rien-et-la-reine/tome/README.md

# tome

seeing if i can make a clamshell ereader + music player from scratch(-ish)

inspired in part by The Open Book (https://github.com/joeycastillo/The-Open-Book)

Firmware: [tavernkeep](https://github.com/rien-et-la-reine/tavernkeep)

## License

Copyright Harsh Patel 2026.

The following notice applies to all hardware design files in this repository.

This source describes Open Hardware and is licensed under the CERN-OHL-S v2.
You may redistribute and modify this source and make products using it under the terms of the CERN-OHL-S v2 (https://ohwr.org/cern_ohl_s_v2.txt).

This source is distributed WITHOUT ANY EXPRESS OR IMPLIED WARRANTY, INCLUDING OF MERCHANTABILITY, SATISFACTORY QUALITY AND FITNESS FOR A PARTICULAR PURPOSE.
Please see the CERN-OHL-S v2 for applicable conditions.

Source location: https://github.com/rien-et-la-reine/tome

As per CERN-OHL-S v2 section 4, should you produce hardware based on this source, you must where practicable maintain the Source Location visible on the external case or other products you make using this source.

Commits up to and including `8ce5c31` were published under CC BY-SA 4.0 and remain available under that licence.
