rien-et-la-reine/tome/Tome.kicad_pcb

## KiCad design Tome.kicad_pcb (2026-08-22)

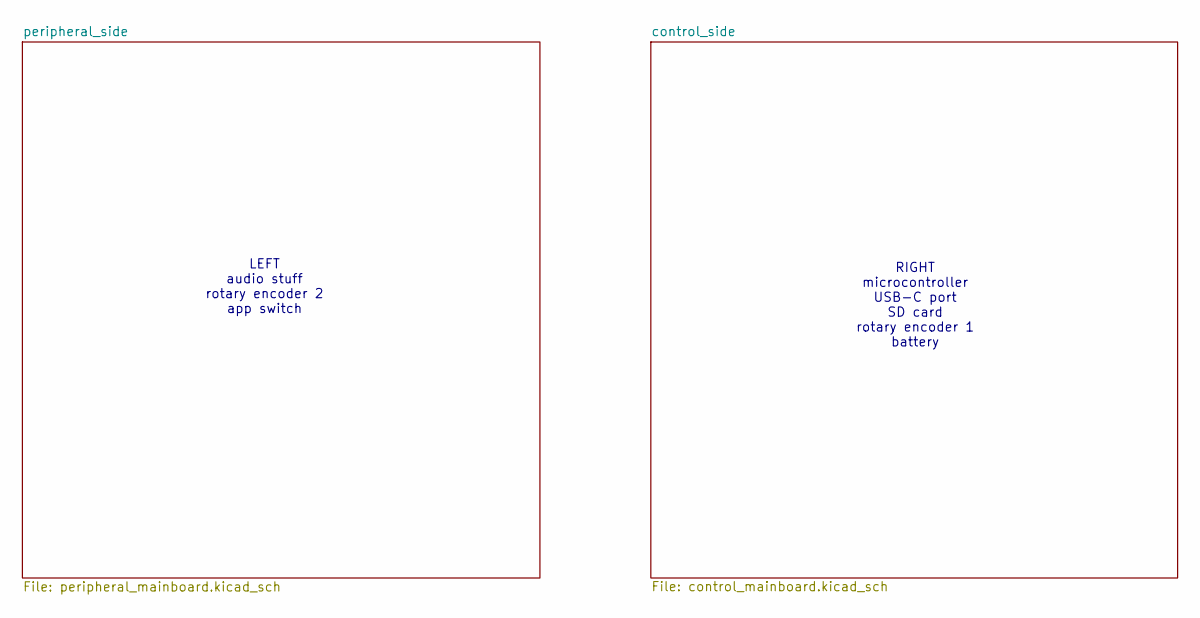
[picture p1: schematic Tome.kicad_sch]

Notes on the sheet:
RIGHT microcontroller USB-C port SD card rotary encoder 1 battery
LEFT audio stuff rotary encoder 2 app switch

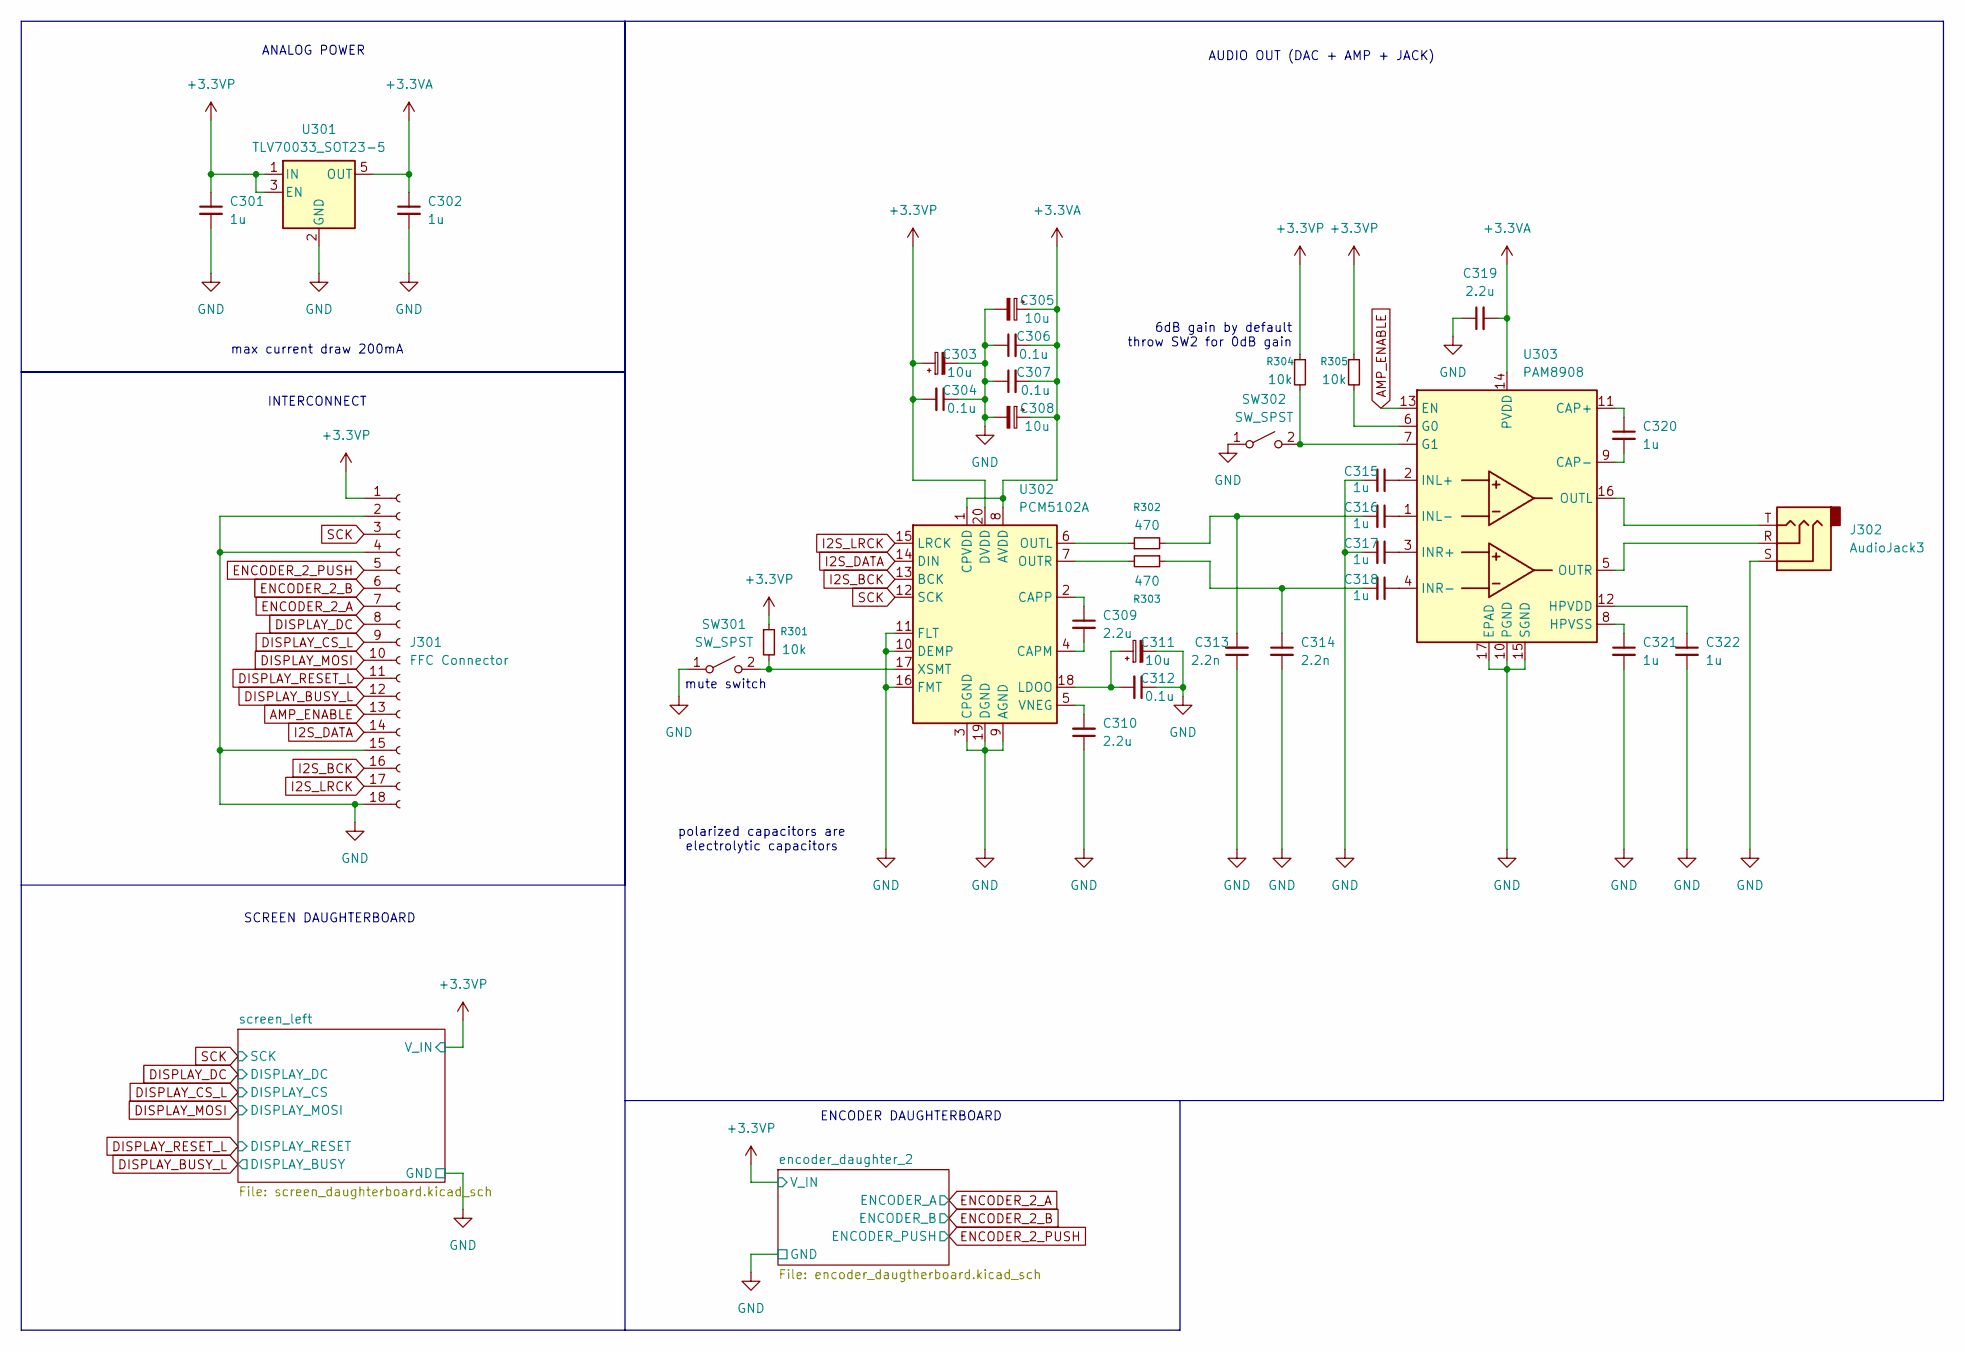
[picture p2: schematic peripheral_mainboard.kicad_sch, Tome: Peripheral-Side Board]

Parts:
C301, C302, C315, C316, C317, C318, C320, C321, C322: 1u; C_0805_2012Metric
C303, C305, C308, C311: 10u; CP_Elec_4x4.5
C304, C306, C307, C312: 0.1u; C_1206_3216Metric
C309, C310, C319: 2.2u; C_0402_1005Metric
C313, C314: 2.2n; C_0805_2012Metric
J301: FFC Connector; JUSHUO_AFA07-S18FCA-00_1x18-1MP_P1.0mm_Horizontal
J302: AudioJack3; Jack_3.5mm_CUI_SJ1-3523N_Horizontal
R301, R304, R305: 10k; R_1206_3216Metric
R302, R303: 470; R_0603_1608Metric
SW301, SW302: SW_SPST; SW_SPDT_CK_JS102011SAQN
U301: TLV70033_SOT23-5; SOT-23-5
U302: PCM5102A; TSSOP-20_4.4x6.5mm_P0.65mm
U303: PAM8908; QFN-16-1EP_3x3mm_P0.5mm_EP1.7x1.7mm

Connections:
+3.3VA: C302.1, C305.1, C306.2, C307.2, C308.1, C319.2, U301.5 (OUT), U302.1 (CPVDD), U302.8 (AVDD), U303.14 (PVDD)
+3.3VP: C301.1, C303.1, C304.2, J301.1, R301.1, R304.1, R305.1, U301.1 (IN), U301.3 (EN), U302.20 (DVDD); also elsewhere on the board
AMP_ENABLE: J301.13, U303.13 (EN); also elsewhere on the board
DISPLAY_BUSY_L: J301.12; also elsewhere on the board
DISPLAY_CS_L: J301.9; also elsewhere on the board
DISPLAY_DC: J301.8; also elsewhere on the board
DISPLAY_MOSI: J301.10; also elsewhere on the board
DISPLAY_RESET_L: J301.11; also elsewhere on the board
ENCODER_2_A: J301.7; also elsewhere on the board
ENCODER_2_B: J301.6; also elsewhere on the board
ENCODER_2_PUSH: J301.5; also elsewhere on the board
GND: C301.2, C302.2, C303.2, C304.1, C305.2, C306.1, C307.1, C308.2, C310.1, C311.2, C312.1, C313.1, C314.2, C315.2, C317.2, C319.1, C321.2, C322.2, J301.2, J301.4, J301.15, J301.18, J302.S, SW301.1 (A), SW302.1 (A), U301.2 (GND), U302.3 (CPGND), U302.9 (AGND), U302.10 (DEMP), U302.11 (FLT), U302.16 (FMT), U302.19 (DGND), U303.10 (PGND), U303.15 (SGND), U303.17 (EPAD); also elsewhere on the board
I2S_BCK: J301.16, U302.13 (BCK); also elsewhere on the board
I2S_DATA: J301.14, U302.14 (DIN); also elsewhere on the board
I2S_LRCK: J301.17, U302.15 (LRCK); also elsewhere on the board
unnamed: C313.2, C316.2, R302.2
unnamed: C314.1, C318.2, R303.1
unnamed: R301.2, SW301.2 (B), U302.17 (XSMT)
unnamed: R304.2, SW302.2 (B), U303.7 (G1)
unnamed: C309.2, U302.4 (CAPM)
unnamed: C309.1, U302.2 (CAPP)
unnamed: C311.1, C312.2, U302.18 (LDOO)
unnamed: R302.1, U302.6 (OUTL)
unnamed: R303.2, U302.7 (OUTR)
unnamed: C310.2, U302.5 (VNEG)
unnamed: C320.1, U303.11 (CAP+)
unnamed: C320.2, U303.9 (CAP-)
unnamed: R305.2, U303.6 (G0)
unnamed: C322.1, U303.12 (HPVDD)
unnamed: C321.1, U303.8 (HPVSS)
unnamed: C315.1, U303.2 (INL+)
unnamed: C316.1, U303.1 (INL-)
unnamed: C317.1, U303.3 (INR+)
unnamed: C318.1, U303.4 (INR-)
unnamed: J302.T, U303.16 (OUTL)
unnamed: J302.R, U303.5 (OUTR)
SCK: J301.3, U302.12 (SCK); also elsewhere on the board

Notes on the sheet:
6dB gain by default throw SW2 for 0dB gain
SCREEN DAUGHTERBOARD
polarized capacitors are electrolytic capacitors
max current draw 200mA
ANALOG POWER
AUDIO OUT (DAC + AMP + JACK)
INTERCONNECT
ENCODER DAUGHTERBOARD
mute switch

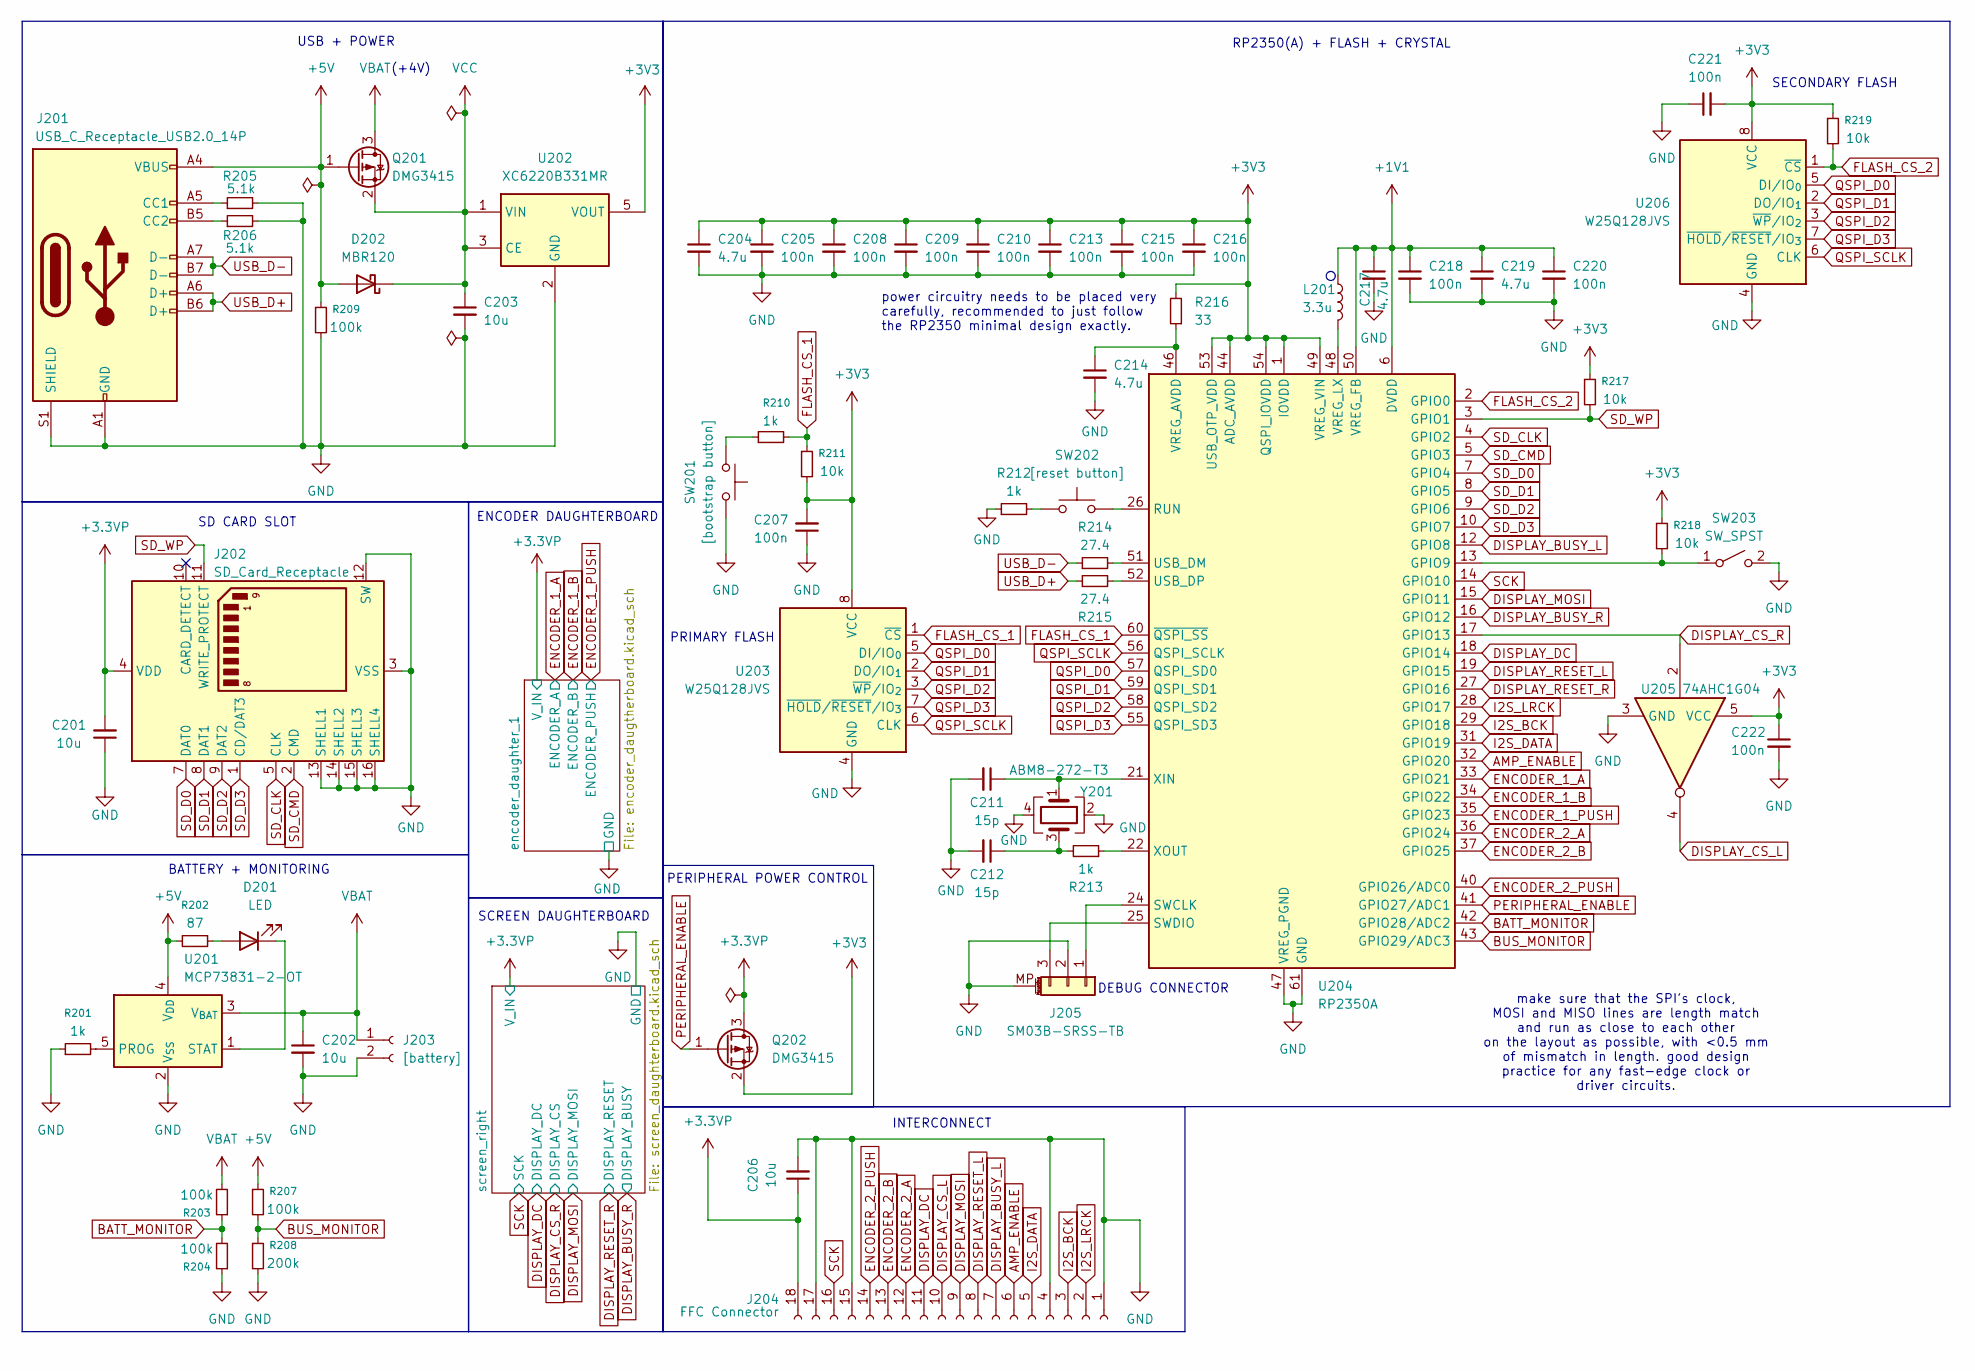
[picture p3: schematic control_mainboard.kicad_sch, Tome: Control-Side Board]

Parts:
C201, C202, C206: 10u; C_0805_2012Metric
C203: 10u; C_0402_1005Metric
C204, C214, C217, C219: 4.7u; C_0402_1005Metric
C205, C207, C208, C209, C210, C213, C215, C216, C218, C220, C221, C222: 100n; C_0402_1005Metric
C211, C212: 15p; C_0402_1005Metric
D201: LED; LED_0603_1608Metric
D202: MBR120; D_SOD-123
J201: USB_C_Receptacle_USB2.0_14P; USB_C_Receptacle_GCT_USB4105-xx-A_16P_TopMnt_Horizontal
J202: SD_Card_Receptacle; SD_Hirose_DM1AA_SF_PEJ82
J203: [battery]; JST_PH_S2B-PH-K_1x02_P2.00mm_Horizontal
J204: FFC Connector; JUSHUO_AFA07-S18FCA-00_1x18-1MP_P1.0mm_Horizontal
J205: SM03B-SRSS-TB; JST_SH_SM03B-SRSS-TB_1x03-1MP_P1.00mm_Horizontal
L201: 3.3u; L_pol_2016
Q201, Q202: DMG3415; SOT-23
R201: 1k; R_1206_3216Metric
R202: 87; R_1206_3216Metric
R203, R204, R207: 100k; R_1206_3216Metric
R205, R206: 5.1k; R_0402_1005Metric
R208: 200k; R_0805_2012Metric
R209: 100k; R_0402_1005Metric
R210, R213: 1k; R_0402_1005Metric
R211, R219: 10k; R_0402_1005Metric
R212: 1k; R_0603_1608Metric
R214, R215: 27.4; R_0402_1005Metric
R216: 33; R_0402_1005Metric
R217, R218: 10k; R_1206_3216Metric
SW201: [bootstrap button]; Panasonic_EVQPUK_EVQPUB
SW202: [reset button]; Panasonic_EVQPUK_EVQPUB
SW203: SW_SPST; SW_SPDT_CK_JS102011SAQN
U201: MCP73831-2-OT; SOT-23-5
U202: XC6220B331MR; SOT-23-5
U203, U206: W25Q128JVS; SOIC-8_5.3x5.3mm_P1.27mm
U204: RP2350A; QFN-60-1EP_7x7mm_P0.4mm_EP3.4x3.4mm
U205: 74AHC1G04; SOT-23-5_HandSoldering
Y201: ABM8-272-T3; Crystal_SMD_3225-4Pin_3.2x2.5mm

Connections:
+1V1: C217.1, C218.1, C219.1, C220.1, L201.1, U204.6 (DVDD), U204.23 (DVDD), U204.39 (DVDD), U204.50 (VREG_FB)
+3.3VP: C201.2, C206.1, J202.4 (VDD), J204.18, Q202.3 (D); also elsewhere on the board
+3V3: C204.1, C205.1, C207.2, C208.1, C209.1, C210.1, C213.1, C215.1, C216.1, C221.2, C222.1, Q202.2 (S), R211.2, R216.2, R217.1, R218.1, R219.1, U202.5 (VOUT), U203.8 (VCC), U204.1 (IOVDD), U204.11 (IOVDD), U204.20 (IOVDD), U204.30 (IOVDD), U204.38 (IOVDD), U204.44 (ADC_AVDD), U204.45 (IOVDD), U204.49 (VREG_VIN), U204.53 (USB_OTP_VDD), U204.54 (QSPI_IOVDD), U205.5 (VCC), U206.8 (VCC)
+5V: D202.2 (A), J201.A4 (VBUS), J201.A9 (VBUS), J201.B4 (VBUS), J201.B9 (VBUS), Q201.1 (G), R202.2, R207.1, R209.1, U201.4 (V_{DD})
AMP_ENABLE: J204.6, U204.32 (GPIO20); also elsewhere on the board
BATT_MONITOR: R203.1, R204.2, U204.42 (GPIO28/ADC2)
BUS_MONITOR: R207.2, R208.1, U204.43 (GPIO29/ADC3)
DISPLAY_BUSY_L: J204.7, U204.12 (GPIO8); also elsewhere on the board
DISPLAY_BUSY_R: U204.16 (GPIO12); also elsewhere on the board
DISPLAY_CS_L: J204.10, U205.4; also elsewhere on the board
DISPLAY_CS_R: U204.17 (GPIO13), U205.2; also elsewhere on the board
DISPLAY_DC: J204.11, U204.18 (GPIO14); also elsewhere on the board
DISPLAY_MOSI: J204.9, U204.15 (GPIO11); also elsewhere on the board
DISPLAY_RESET_L: J204.8, U204.19 (GPIO15); also elsewhere on the board
DISPLAY_RESET_R: U204.27 (GPIO16); also elsewhere on the board
ENCODER_1_A: U204.33 (GPIO21); also elsewhere on the board
ENCODER_1_B: U204.34 (GPIO22); also elsewhere on the board
ENCODER_1_PUSH: U204.35 (GPIO23); also elsewhere on the board
ENCODER_2_A: J204.12, U204.36 (GPIO24); also elsewhere on the board
ENCODER_2_B: J204.13, U204.37 (GPIO25); also elsewhere on the board
ENCODER_2_PUSH: J204.14, U204.40 (GPIO26/ADC0); also elsewhere on the board
FLASH_CS_1: R210.2, R211.1, U203.1 (~CS), U204.60 (~QSPI_SS)
FLASH_CS_2: R219.2, U204.2 (GPIO0), U206.1 (~CS)
GND: C201.1, C202.2, C203.2, C204.2, C205.2, C206.2, C207.1, C208.2, C209.2, C210.2, C211.2, C212.2, C213.2, C214.2, C215.2, C216.2, C217.2, C218.2, C219.2, C220.2, C221.1, C222.2, J201.A1 (GND), J201.A12 (GND), J201.B1 (GND), J201.B12 (GND), J201.S1 (SHIELD), J202.3 (VSS), J202.6 (VSS), J202.12 (SW), J202.13 (SHELL1), J202.14 (SHELL2), J202.15 (SHELL3), J202.16 (SHELL4), J203.2, J204.1, J204.4, J204.15, J204.17, J205.2, J205.MP (MountPin), R201.1, R204.1, R205.2, R206.2, R208.2, R209.2, R212.1, SW201.2, SW203.2 (B), U201.2 (V_{SS}), U202.2 (GND), U203.4 (GND), U204.47 (VREG_PGND), U204.61 (GND), U205.3 (GND), U206.4 (GND), Y201.2, Y201.4; also elsewhere on the board
I2S_BCK: J204.3, U204.29 (GPIO18); also elsewhere on the board
I2S_DATA: J204.5, U204.31 (GPIO19); also elsewhere on the board
I2S_LRCK: J204.2, U204.28 (GPIO17); also elsewhere on the board
unnamed: C212.1, R213.2, Y201.3
unnamed: D201.2 (A), R202.1
unnamed: D201.1 (K), U201.1 (STAT)
unnamed: J201.A5 (CC1), R205.1
unnamed: J201.B5 (CC2), R206.1
unnamed: J205.1, U204.24 (SWCLK)
unnamed: J205.3, U204.25 (SWDIO)
unnamed: R210.1, SW201.1
unnamed: R212.2, SW202.1
unnamed: R218.2, SW203.1 (A), U204.13 (GPIO9)
unnamed: R201.2, U201.5 (PROG)
unnamed: SW202.2, U204.26 (RUN)
unnamed: R214.2, U204.51 (USB_DM)
unnamed: R215.2, U204.52 (USB_DP)
unnamed: C214.1, R216.1, U204.46 (VREG_AVDD)
unnamed: L201.2, U204.48 (VREG_LX)
unnamed: C211.1, U204.21 (XIN), Y201.1
unnamed: R213.1, U204.22 (XOUT)
PERIPHERAL_ENABLE: Q202.1 (G), U204.41 (GPIO27/ADC1)
QSPI_D0: U203.5 (DI/IO_{0}), U204.57 (QSPI_SD0), U206.5 (DI/IO_{0})
QSPI_D1: U203.2 (DO/IO_{1}), U204.59 (QSPI_SD1), U206.2 (DO/IO_{1})
QSPI_D2: U203.3 (~WP/IO_{2}), U204.58 (QSPI_SD2), U206.3 (~WP/IO_{2})
QSPI_D3: U203.7 (~HOLD/~RESET/IO_{3}), U204.55 (QSPI_SD3), U206.7 (~HOLD/~RESET/IO_{3})
QSPI_SCLK: U203.6 (CLK), U204.56 (QSPI_SCLK), U206.6 (CLK)
SCK: J204.16, U204.14 (GPIO10); also elsewhere on the board
SD_CLK: J202.5 (CLK), U204.4 (GPIO2)
SD_CMD: J202.2 (CMD), U204.5 (GPIO3)
SD_D0: J202.7 (DAT0), U204.7 (GPIO4)
SD_D1: J202.8 (DAT1), U204.8 (GPIO5)
SD_D2: J202.9 (DAT2), U204.9 (GPIO6)
SD_D3: J202.1 (CD/DAT3), U204.10 (GPIO7)
SD_WP: J202.11 (WRITE_PROTECT), R217.2, U204.3 (GPIO1)
USB_D+: J201.A6 (D+), J201.B6 (D+), R215.1
USB_D-: J201.A7 (D-), J201.B7 (D-), R214.1
VBAT: C202.1, J203.1, Q201.3 (D), R203.2, U201.3 (V_{BAT})
VCC: C203.1, D202.1 (K), Q201.2 (S), U202.1 (VIN), U202.3 (CE)

Notes on the sheet:
SCREEN DAUGHTERBOARD
SECONDARY FLASH
DEBUG CONNECTOR
SD CARD SLOT
make sure that the SPI's clock, MOSI and MISO lines are length match and run as close to each other on the layout as possible, with <0.5 mm of mismatch in length. good design practice for any fast-edge clock or driver circuits.
INTERCONNECT
power circuitry needs to be placed very carefully, recommended to just follow the RP2350 minimal design exactly.
BATTERY + MONITORING
PRIMARY FLASH
ENCODER DAUGHTERBOARD
(+4V)
PERIPHERAL POWER CONTROL
USB + POWER
RP2350(A) + FLASH + CRYSTAL

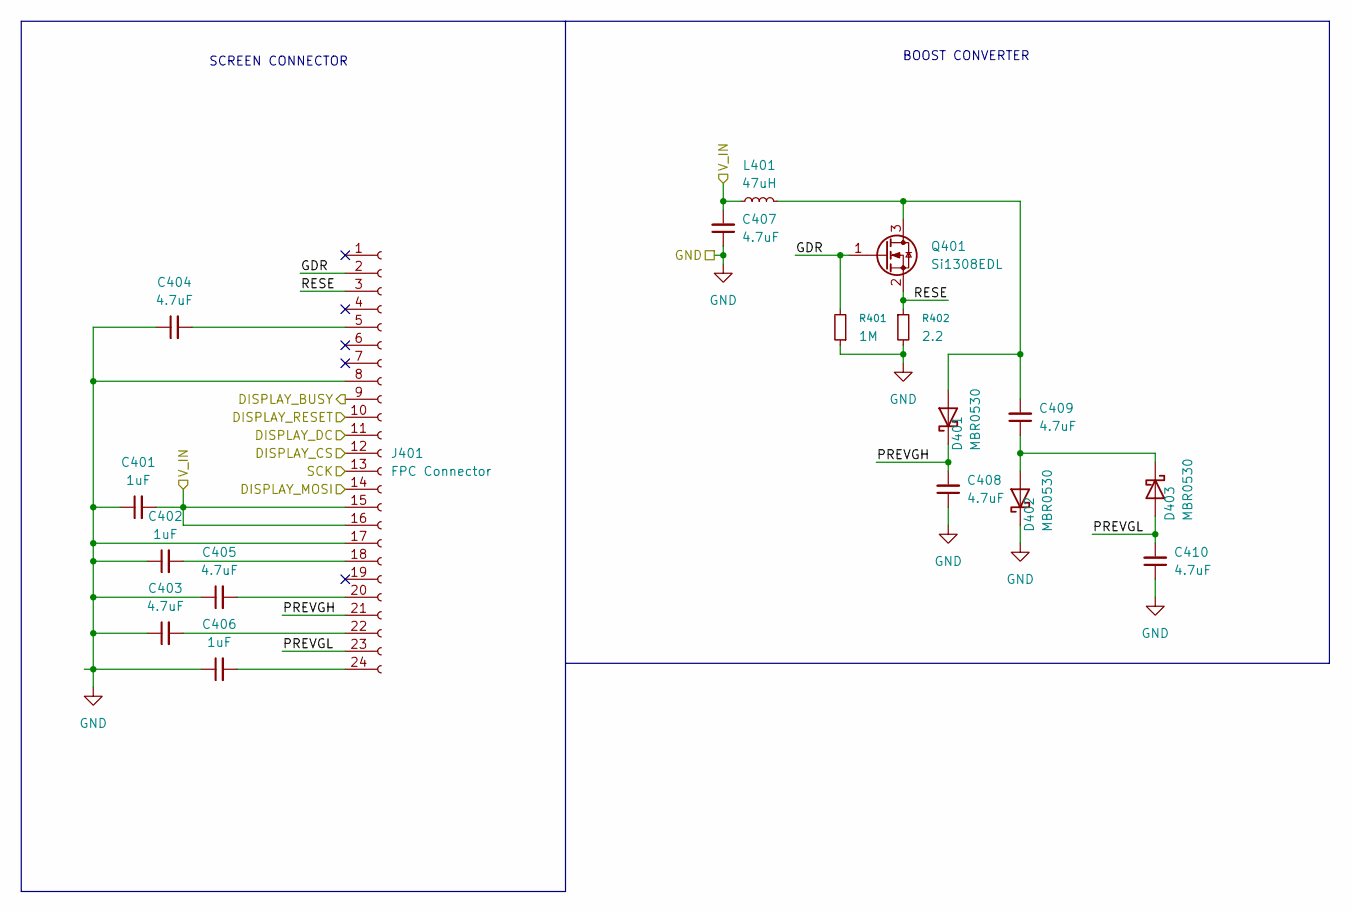
[picture p4: schematic screen_daughterboard.kicad_sch, Tome: Display Daughterboard]

Parts:
C401, C402, C406: 1uF; C_0805_2012Metric
C403, C404, C405, C407, C408, C409, C410: 4.7uF; C_0402_1005Metric
D401, D402, D403: MBR0530; D_SOD-123
J401: FPC Connector; Hirose_FH12-24S-0.5SH_1x24-1MP_P0.50mm_Horizontal
L401: 47uH; L_APV_ANR3015
Q401: Si1308EDL; SOT-323_SC-70
R401: 1M; R_0805_2012Metric
R402: 2.2; R_0603_1608Metric

Connections:
+3.3VP: C401.2, C407.2, J401.15, J401.16, L401.1; also elsewhere on the board
/control_side/screen_right/GDR: J401.2, Q401.1 (G), R401.2
/control_side/screen_right/PREVGH: C408.2, D401.1 (K), J401.21
/control_side/screen_right/PREVGL: C410.2, D403.2 (A), J401.23
/control_side/screen_right/RESE: J401.3, Q401.2 (S), R402.1
DISPLAY_BUSY_R: J401.9; also elsewhere on the board
DISPLAY_CS_R: J401.12; also elsewhere on the board
DISPLAY_DC: J401.11; also elsewhere on the board
DISPLAY_MOSI: J401.14; also elsewhere on the board
DISPLAY_RESET_R: J401.10; also elsewhere on the board
GND: C401.1, C402.1, C403.1, C404.1, C405.1, C406.1, C407.1, C408.1, C410.1, D402.1 (K), J401.8, J401.17, R401.1, R402.2; also elsewhere on the board
unnamed: C409.2, D401.2 (A), L401.2, Q401.3 (D)
unnamed: C409.1, D402.2 (A), D403.1 (K)
unnamed: C404.2, J401.5
unnamed: C402.2, J401.18
unnamed: C405.2, J401.20
unnamed: C403.2, J401.22
unnamed: C406.2, J401.24
SCK: J401.13; also elsewhere on the board

Parts of its further copies:
C501, C502, C506: 1uF; C_0805_2012Metric
C503, C504, C505, C507, C508, C509, C510: 4.7uF; C_0402_1005Metric
D501, D502, D503: MBR0530; D_SOD-123
J501: FPC Connector; Hirose_FH12-24S-0.5SH_1x24-1MP_P0.50mm_Horizontal
L501: 47uH; L_APV_ANR3015
Q501: Si1308EDL; SOT-323_SC-70
R501: 1M; R_0805_2012Metric
R502: 2.2; R_0603_1608Metric

Connections of its further copies:
+3.3VP: C501.2, C507.2, J501.15, J501.16, L501.1; also elsewhere on the board
/peripheral_side/screen_left/GDR: J501.2, Q501.1 (G), R501.2
/peripheral_side/screen_left/PREVGH: C508.2, D501.1 (K), J501.21
/peripheral_side/screen_left/PREVGL: C510.2, D503.2 (A), J501.23
/peripheral_side/screen_left/RESE: J501.3, Q501.2 (S), R502.1
DISPLAY_BUSY_L: J501.9; also elsewhere on the board
DISPLAY_CS_L: J501.12; also elsewhere on the board
DISPLAY_DC: J501.11; also elsewhere on the board
DISPLAY_MOSI: J501.14; also elsewhere on the board
DISPLAY_RESET_L: J501.10; also elsewhere on the board
GND: C501.1, C502.1, C503.1, C504.1, C505.1, C506.1, C507.1, C508.1, C510.1, D502.1 (K), J501.8, J501.17, R501.1, R502.2; also elsewhere on the board
unnamed: C509.2, D501.2 (A), L501.2, Q501.3 (D)
unnamed: C509.1, D502.2 (A), D503.1 (K)
unnamed: C504.2, J501.5
unnamed: C502.2, J501.18
unnamed: C505.2, J501.20
unnamed: C503.2, J501.22
unnamed: C506.2, J501.24
SCK: J501.13; also elsewhere on the board

Notes on the sheet:
BOOST CONVERTER
SCREEN CONNECTOR

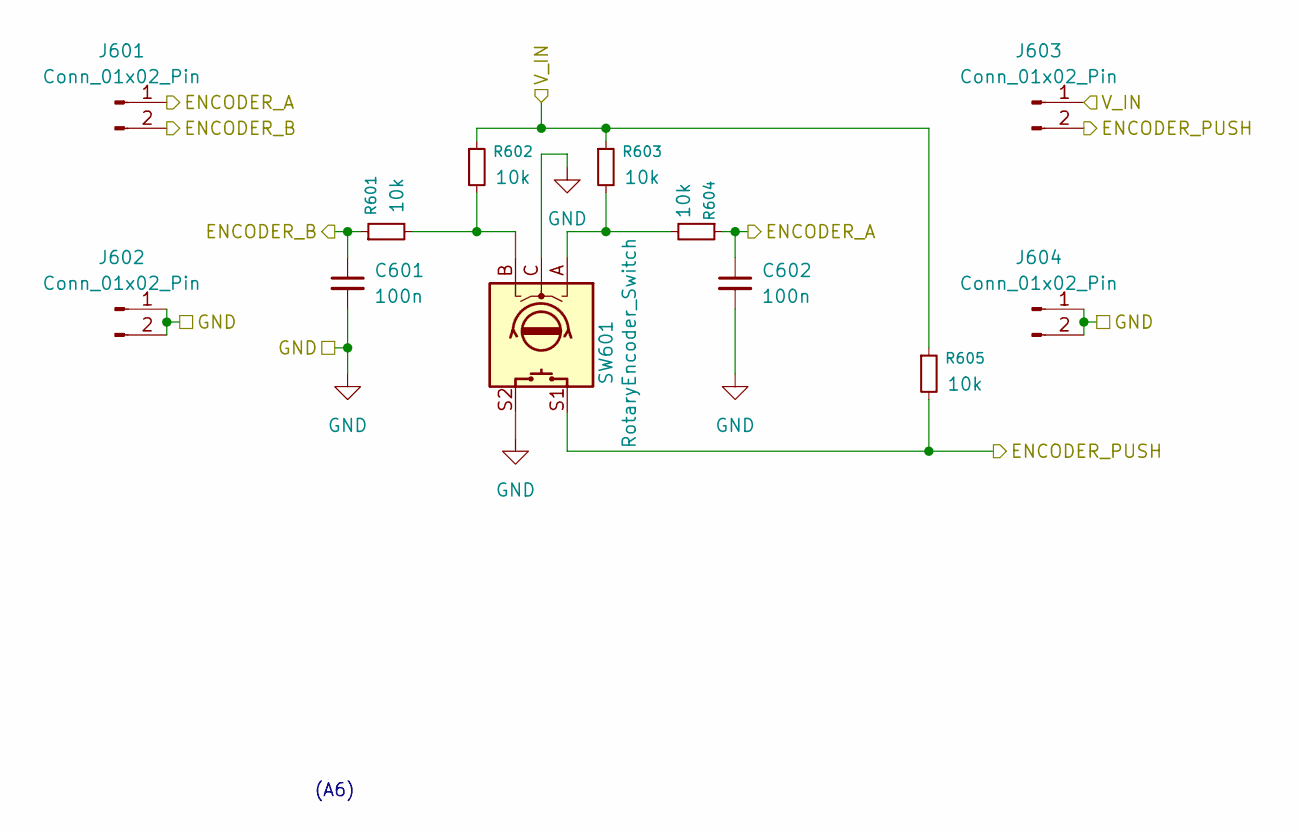
[picture p5: schematic encoder_daugtherboard.kicad_sch, Tome: Encoder Daughterboard]

Parts:
C601, C602: 100n; C_0402_1005Metric
J601, J602, J603, J604: Conn_01x02_Pin; PinHeader_1x02_P2.00mm_Vertical
R601, R602, R603, R604, R605: 10k; R_1206_3216Metric
SW601: RotaryEncoder_Switch; RotaryEncoder_Alps_EC11E-Switch_Vertical_H20mm

Connections:
+3.3VP: J603.1, R602.1, R603.1, R605.1; also elsewhere on the board
ENCODER_1_A: C602.1, J601.1, R604.1; also elsewhere on the board
ENCODER_1_B: C601.1, J601.2, R601.1; also elsewhere on the board
ENCODER_1_PUSH: J603.2, R605.2, SW601.S1; also elsewhere on the board
GND: C601.2, C602.2, J602.1, J602.2, J604.1, J604.2, SW601.C, SW601.S2; also elsewhere on the board
unnamed: R601.2, R602.2, SW601.B
unnamed: R603.2, R604.2, SW601.A

Parts of its further copies:
C701, C702: 100n; C_0402_1005Metric
J701, J702, J703, J704: Conn_01x02_Pin; PinHeader_1x02_P2.00mm_Vertical
R701, R702, R703, R704, R705: 10k; R_1206_3216Metric
SW701: RotaryEncoder_Switch; RotaryEncoder_Alps_EC11E-Switch_Vertical_H20mm

Connections of its further copies:
+3.3VP: J703.1, R702.1, R703.1, R705.1; also elsewhere on the board
ENCODER_2_A: C702.1, J701.1, R704.1; also elsewhere on the board
ENCODER_2_B: C701.1, J701.2, R701.1; also elsewhere on the board
ENCODER_2_PUSH: J703.2, R705.2, SW701.S1; also elsewhere on the board
GND: C701.2, C702.2, J702.1, J702.2, J704.1, J704.2, SW701.C, SW701.S2; also elsewhere on the board
unnamed: R701.2, R702.2, SW701.B
unnamed: R703.2, R704.2, SW701.A

Notes on the sheet:
(A6)

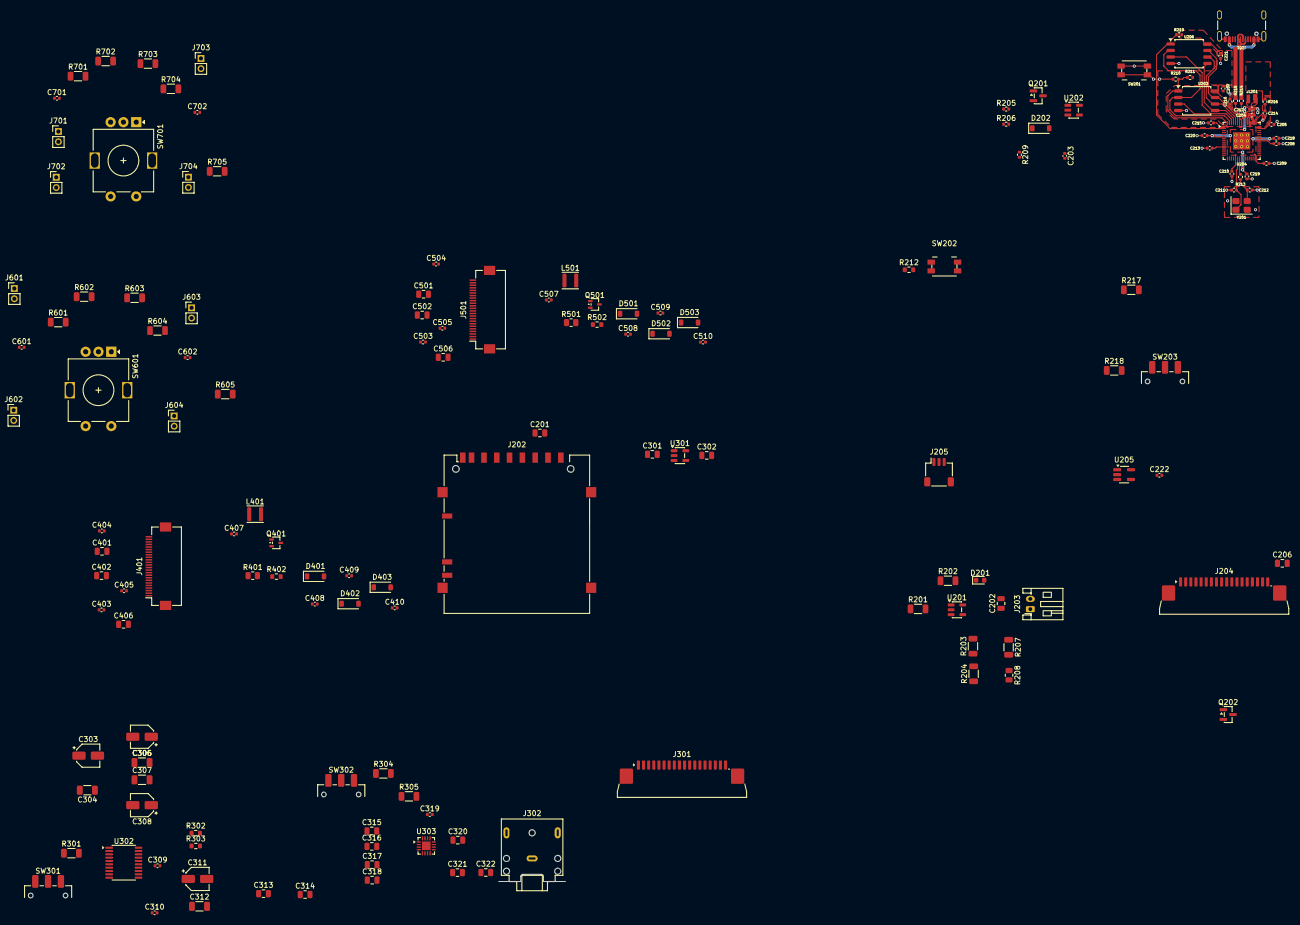
[picture p6: board Tome.kicad_pcb from above]

Board: 2 copper layers, 155 parts (0 on the bottom side), 111 nets.
