rien-et-la-reine/tome/(commit log)

2026-02-05 upload KiCad Project
    [Tome.kicad_pcb, Tome.kicad_sch, encoder_daughterboard.kicad_sch, encoder_daugtherboard.kicad_sch]
2026-02-05 update page size
    [encoder_daugtherboard.kicad_sch]
2026-02-05 unused schematic removal
    [encoder_daughterboard.kicad_sch]
2026-02-05 adjusting pin assignments
    [Tome.kicad_sch]
2026-02-05 fixing pullup resistors
    [Tome.kicad_sch]
2026-02-06 removing incorrect pullups
    [Tome.kicad_sch]
2026-02-06 split schematic based on physical PCB split
    [Tome.kicad_sch, control_mainboard.kicad_sch, encoder_daugtherboard.kicad_sch, peripheral_mainboard.kicad_sch, screen_daughterboard.kicad_sch]
2026-02-06 fixed page numbers
    and adjusted some label types
    [Tome.kicad_sch, control_mainboard.kicad_sch, encoder_daugtherboard.kicad_sch, peripheral_mainboard.kicad_sch, screen_daughterboard.kicad_sch]
2026-02-07 separating schematics based on board
    finished splitting every component up into separate sheets in the schematic based on what physical board it's going on
    [Tome.kicad_sch, control_mainboard.kicad_sch, encoder_daugtherboard.kicad_sch, peripheral_mainboard.kicad_sch, screen_daughterboard.kicad_sch]
2026-02-08 assigning pcb footprints
    assigned pcb footprints to most components:
    - rotary encoder footprint will need slight modification to fit bourns PEC11L
    - need to finalize components for reset button and the four switches before assigning those footprints
    [control_mainboard.kicad_sch, encoder_daugtherboard.kicad_sch, peripheral_mainboard.kicad_sch, screen_daughterboard.kicad_sch]
2026-02-08 removed external footprint/model
    these were from ultralibrarian and should never have been included here, my bad
    [peripheral_mainboard.kicad_sch]
2026-02-08 replaced DAC footprint
    there was literally a built-in footprint for the DAC in kicad already the whole time...
    [peripheral_mainboard.kicad_sch]
2026-02-09 finalizing schematics
    connected the new DAC footprint, filled in title blocks
    [Tome.kicad_sch, control_mainboard.kicad_sch, encoder_daugtherboard.kicad_sch, peripheral_mainboard.kicad_sch, screen_daughterboard.kicad_sch]
2026-02-11 corrected connector orientation
    [control_mainboard.kicad_sch]
2026-02-12 working on PCBs
    [Tome.kicad_pcb, encoder_daugtherboard.kicad_sch]
2026-02-12 assigned switch and reset button footprints
    all footprints now assigned*
    *will probably need something to connect the encoder daughterboard to the main boards
    [control_mainboard.kicad_sch, peripheral_mainboard.kicad_sch]
2026-02-12 different encoder board layout
    [Tome.kicad_pcb, encoder_daugtherboard.kicad_sch]
2026-02-16 workshopping encoder board
    [Tome.kicad_pcb, encoder_daugtherboard.kicad_sch]
2026-02-20 switching to RP2350
    [control_mainboard.kicad_sch, encoder_daugtherboard.kicad_sch, screen_daughterboard.kicad_sch]
2026-02-23 wiring write protect to card detect
    need to reduce GPIO pins used so wiring write protect on the SD card port to lock card detect high directly instead of connecting to the microcontroller. this should prevent the card from being detected at all if it's write protected, which is important because we cannot write bookmarks into a card that is read only (and I don't want to make a read-only mode, I don't see a reason to write protect a books/audio files card anyway)
    [control_mainboard.kicad_sch]
2026-02-23 simplified card detect/write protect
    read the datasheet wrong, can just use the write protect pin, it's open when inserted card is write protected and also when there is no card, and pulled down when a card that is write enabled is inserted, so it can also work as a card detect.
    [control_mainboard.kicad_sch]
2026-02-23 update left/right interconnect
    [control_mainboard.kicad_sch, peripheral_mainboard.kicad_sch]
2026-02-23 charge status LED
    [control_mainboard.kicad_sch]
2026-02-24 updating schematic
    [control_mainboard.kicad_sch, encoder_daugtherboard.kicad_sch, peripheral_mainboard.kicad_sch, screen_daughterboard.kicad_sch]
2026-02-24 added secondary flash to schematic
    [control_mainboard.kicad_sch]
2026-08-10 update footprints and labeling
    [Tome.kicad_pcb, Tome.kicad_sch, control_mainboard.kicad_sch, encoder_daugtherboard.kicad_sch, peripheral_mainboard.kicad_sch, screen_daughterboard.kicad_sch]
2026-08-11 grouping
    grouping components together based on schematic to organize things, in prep for arranging them for routing
    [Tome.kicad_pcb, control_mainboard.kicad_sch]
2026-08-13 voltage regulator circuit
    routed the voltage regulator circuit following strongly suggested layout from the rp2350 hardware design doc, sized decoupling capacitors down
    [Tome.kicad_pcb, control_mainboard.kicad_sch, encoder_daugtherboard.kicad_sch, screen_daughterboard.kicad_sch]
2026-08-13 started placing decoupling capacitors
    [Tome.kicad_pcb, control_mainboard.kicad_sch]
2026-08-14 crystal oscillator
    [Tome.kicad_pcb, control_mainboard.kicad_sch]
2026-08-17 flash chip and usb data lines
    [Tome.kicad_pcb, control_mainboard.kicad_sch]
2026-08-17 zones
    extended some of the copper fill
    [Tome.kicad_pcb]
2026-08-19 secondary flash
    optional, don't anticipate needing it but who knows, could be useful
    [Tome.kicad_pcb, control_mainboard.kicad_sch]
2026-08-22 fixed ground fragmentation
    don't break the ground plane under the qspi traces idiot
    [Tome.kicad_pcb, control_mainboard.kicad_sch]
2026-11-09 transferred power decouple and crystal circuitry
2026-11-10 tentative pin labels
